MattSpot10/ecen340_boards/flash_sar_adc/flash_sar_adc/flash_sar_adc.kicad_pcb

## KiCad design flash_sar_adc/flash_sar_adc/flash_sar_adc.kicad_pcb (2026-04-08)

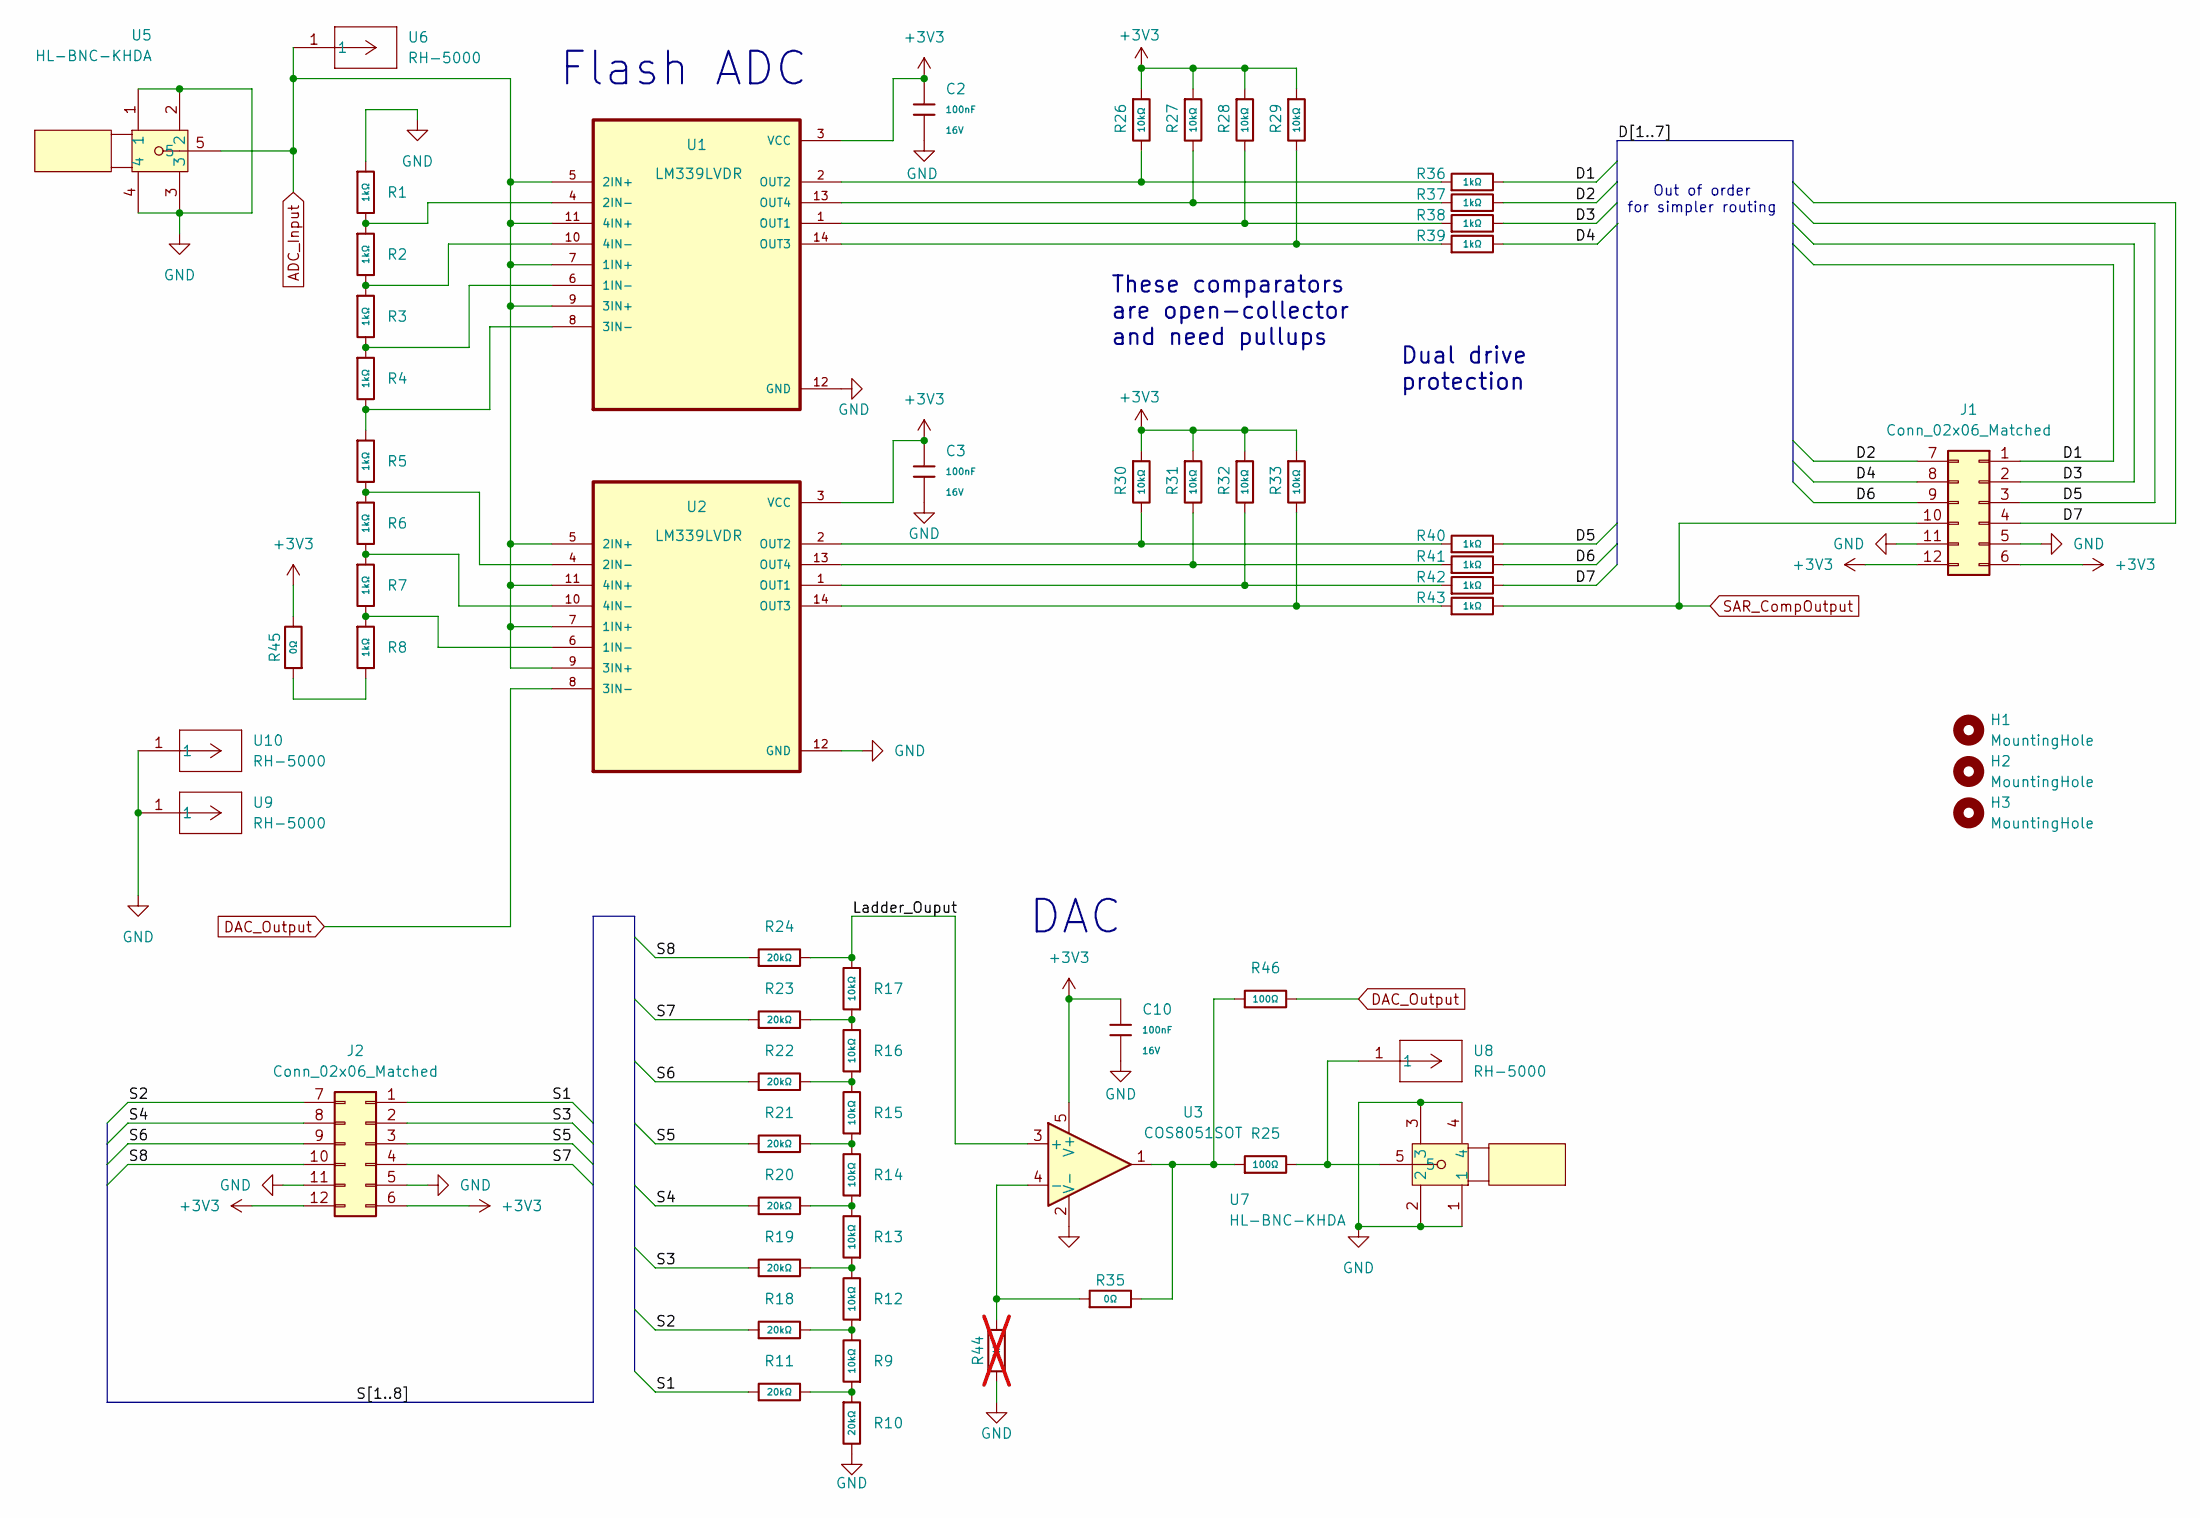
[picture p1: schematic flash_sar_adc.kicad_sch]

Parts:
C2, C3, C10: 100nF; C_0402; Voltage Rated 16V; Tolerance ±10%; Part CL05B104KO5NNNC; LCSC C1525
H1, H2, H3: MountingHole; MountingHole_3.5mm
J1, J2: Conn_02x06_Matched; PinHeader_2x06_P2.54mm_Vertical; LCSC C5383091
R1, R2, R3, R4, R5, R6, R7, R8, R36, R37, R38, R39, R40, R41, R42, R43: 1kΩ; R_0402; Overload Voltage (Max) 50V; Tolerance ±1%; Part 0402WGF1001TCE; LCSC C11702
R9, R12, R13, R14, R15, R16, R17, R26, R27, R28, R29, R30, R31, R32, R33: 10kΩ; R_0402; Overload Voltage (Max) 50V; Tolerance ±1%; Part 0402WGF1002TCE; LCSC C25744
R10, R11, R18, R19, R20, R21, R22, R23, R24: 20kΩ; R_0402; Overload Voltage (Max) 50V; Tolerance ±1%; Part 0402WGF2002TCE; LCSC C25765
R25, R46: 100Ω; R_0402; Overload Voltage (Max) 50V; Tolerance ±1%; Part 0402WGF1000TCE; LCSC C25076
R35, R45: 0Ω; R_0402; Overload Voltage (Max) 50V; Tolerance ±1%; Part 0402WGF0000TCE; LCSC C17168
R44: NA; R_0402; not fitted
U1, U2: LM339LVDR; SOIC127P600X175-14N; LCSC C22427665
U3: COS8051SOT; SOT-23-5; LCSC C7463385
U5, U7: HL-BNC-KHDA; BNC-TH_L12.0-W12.0; LCSC Part C19712152
U6, U8, U9, U10: RH-5000; CONN1_1514-2_KEY; Mouser Part Number 534-1514-2

Connections:
+3V3: C2.1, C3.1, C10.1, J1.6, J1.12, J2.6, J2.12, R26.1, R27.1, R28.1, R29.1, R30.1, R31.1, R32.1, R33.1, R45.2, U1.3 (VCC), U2.3 (VCC), U3.5 (V+)
/D1: J1.1, R36.2
/D2: J1.7, R37.2
/D3: J1.2, R38.2
/D4: J1.8, R39.2
/D5: J1.3, R40.2
/D6: J1.9, R41.2
/D7: J1.4, R42.2
/Ladder_Ouput: R17.2, R24.2, U3.3 (+)
/S1: J2.1, R11.1
/S2: J2.7, R18.1
/S3: J2.2, R19.1
/S4: J2.8, R20.1
/S5: J2.3, R21.1
/S6: J2.9, R22.1
/S7: J2.4, R23.1
/S8: J2.10, R24.1
ADC_Input: U1.5 (2IN+), U1.7 (1IN+), U1.9 (3IN+), U1.11 (4IN+), U2.5 (2IN+), U2.7 (1IN+), U2.9 (3IN+), U2.11 (4IN+), U5.5, U6.1
DAC_Output: R46.2, U2.8 (3IN-)
GND: C2.2, C3.2, C10.2, J1.5, J1.11, J2.5, J2.11, R1.1, R10.2, R44.1, U1.12 (GND), U2.12 (GND), U3.2 (V-), U5.1, U5.2, U5.3, U5.4, U7.1, U7.2, U7.3, U7.4, U9.1, U10.1
unnamed: R9.1, R10.1, R11.2
unnamed: R9.2, R12.1, R18.2
unnamed: R12.2, R13.1, R19.2
unnamed: R13.2, R14.1, R20.2
unnamed: R14.2, R15.1, R21.2
unnamed: R15.2, R16.1, R22.2
unnamed: R16.2, R17.1, R23.2
unnamed: R25.1, R35.2, R46.1, U3.1
unnamed: R25.2, U7.5, U8.1
unnamed: R8.2, R45.1
unnamed: R3.2, R4.1, U1.6 (1IN-)
unnamed: R1.2, R2.1, U1.4 (2IN-)
unnamed: R4.2, R5.1, U1.8 (3IN-)
unnamed: R2.2, R3.1, U1.10 (4IN-)
unnamed: R28.2, R38.1, U1.1 (OUT1)
unnamed: R26.2, R36.1, U1.2 (OUT2)
unnamed: R29.2, R39.1, U1.14 (OUT3)
unnamed: R27.2, R37.1, U1.13 (OUT4)
unnamed: R7.2, R8.1, U2.6 (1IN-)
unnamed: R5.2, R6.1, U2.4 (2IN-)
unnamed: R6.2, R7.1, U2.10 (4IN-)
unnamed: R32.2, R42.1, U2.1 (OUT1)
unnamed: R30.2, R40.1, U2.2 (OUT2)
unnamed: R33.2, R43.1, U2.14 (OUT3)
unnamed: R31.2, R41.1, U2.13 (OUT4)
unnamed: R35.1, R44.2, U3.4 (-)
SAR_CompOutput: J1.10, R43.2

Notes on the sheet:
DAC
Dual drive protection
Out of order for simpler routing
Flash ADC
These comparators are open-collector and need pullups

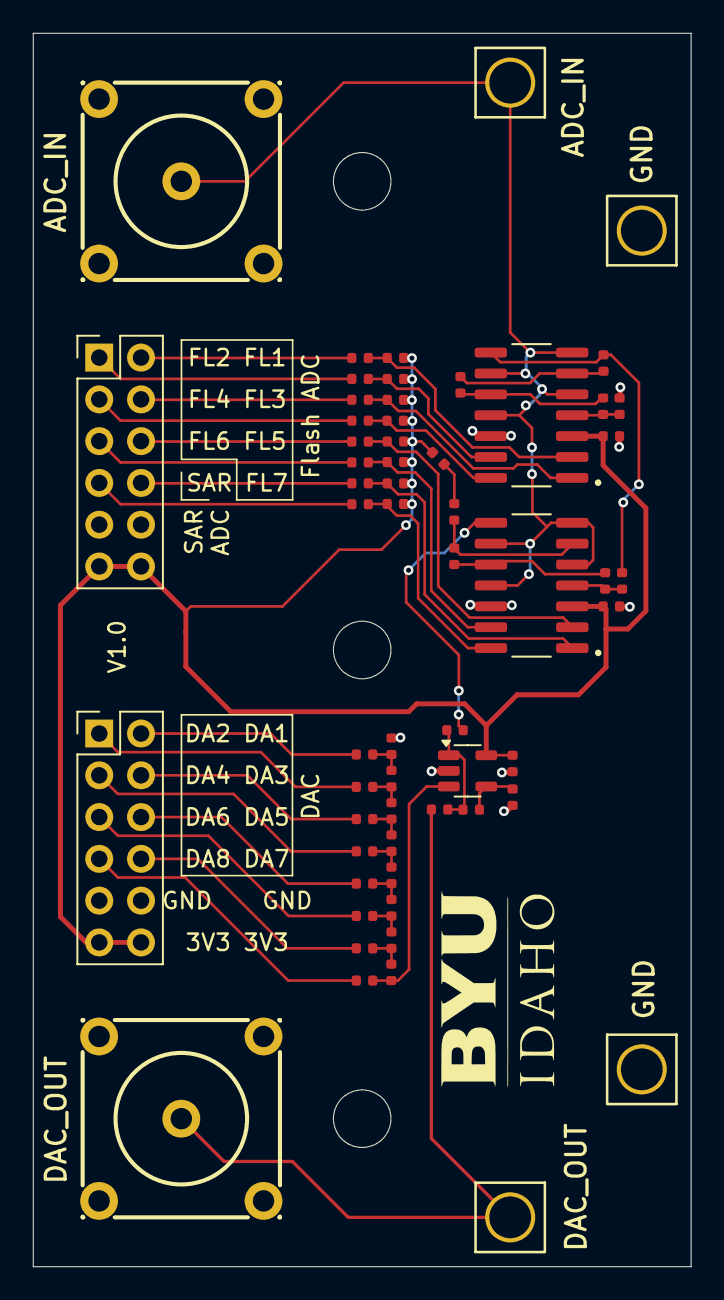
[picture p2: board flash_sar_adc.kicad_pcb from above]

Board: 2 copper layers, 40.0 x 75.0 mm, 62 parts (0 on the bottom side), 47 nets.
