MattSpot10/ecen340_boards/(commit log)

2026-01-24 finished initial schematic
    [flash_sar_adc.kicad_pcb, flash_sar_adc.kicad_sch]
2026-01-24 added Test Points
    [flash_sar_adc.kicad_sch]
2026-04-07 finished flash/sar adc board
    [flash_sar_adc.kicad_pcb, flash_sar_adc.kicad_sch]
2026-04-07 added gerbers
    [bom.csv, designators.csv, positions.csv]
2026-04-07 fixed power supply errors
    [bom.csv, designators.csv, flash_sar_adc.kicad_pcb, flash_sar_adc.kicad_sch, positions.csv]
2026-04-07 fixed bom errors
    [bom.csv, flash_sar_adc.kicad_pcb, flash_sar_adc.kicad_sch]
2026-04-07 added version number
    [bom.csv, flash_sar_adc.kicad_pcb]
2026-04-08 fixed a few more silkscreen errors
    [flash_sar_adc.kicad_pcb, flash_sar_adc.kicad_sch]
